Natheer-Muwonge/autonomous-survey-robot/cad/otv-overview.pdf

## Aruco Marker Above Battery

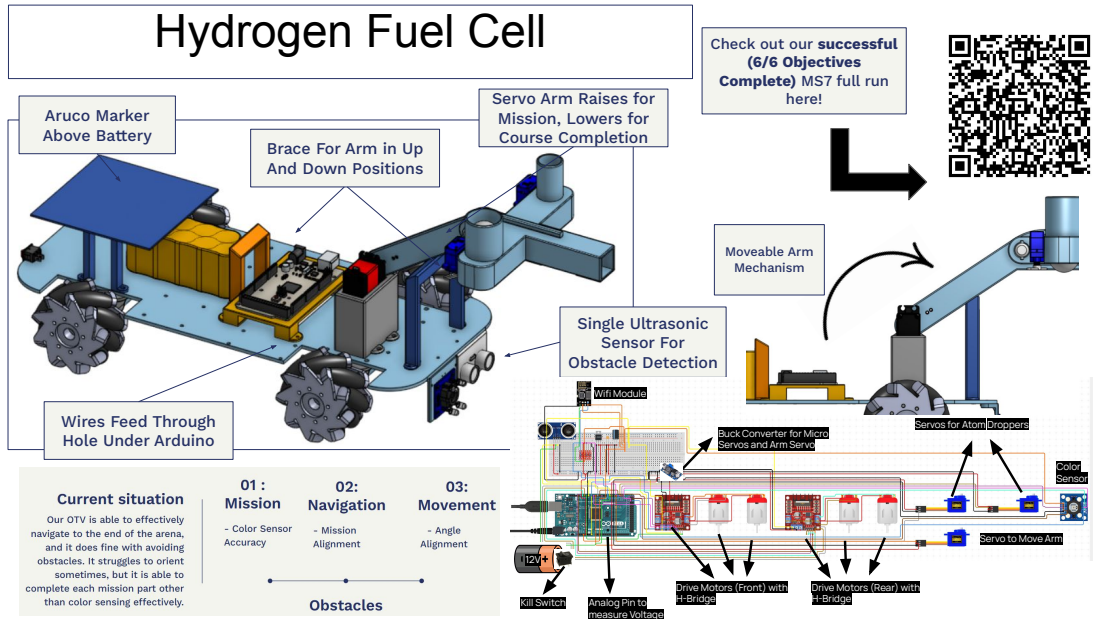
[picture p2: page 1]
Single Ultrasonic Sensor For Obstacle Detection; Wifi Module; Color Sensor; Kill Switch; Moveable Arm Mechanism; here!

Hydrogen Fuel Cell

Check out our successful
(6/6 Objectives
Complete) MS7 full run

Servo Arm Raises for
Mission, Lowers for
Course Completion

Brace For Arm in Up
And Down Positions

Wires Feed Through
Hole Under Arduino

Servos for Atom Droppers

Buck Converter for Micro
Servos and Arm Servo

Servo to Move Arm

Drive Motors (Front) with
H-Bridge

Drive Motors (Rear) with

Analog Pin to
measure Voltage
